HorrorTroll/Artemisia/README.md

# Artemisia
A Pro Micro using ArteryTek AT32F415 MCU
