HorrorTroll/Artemisia/images/castellated_holes/artemisia_back_2.png

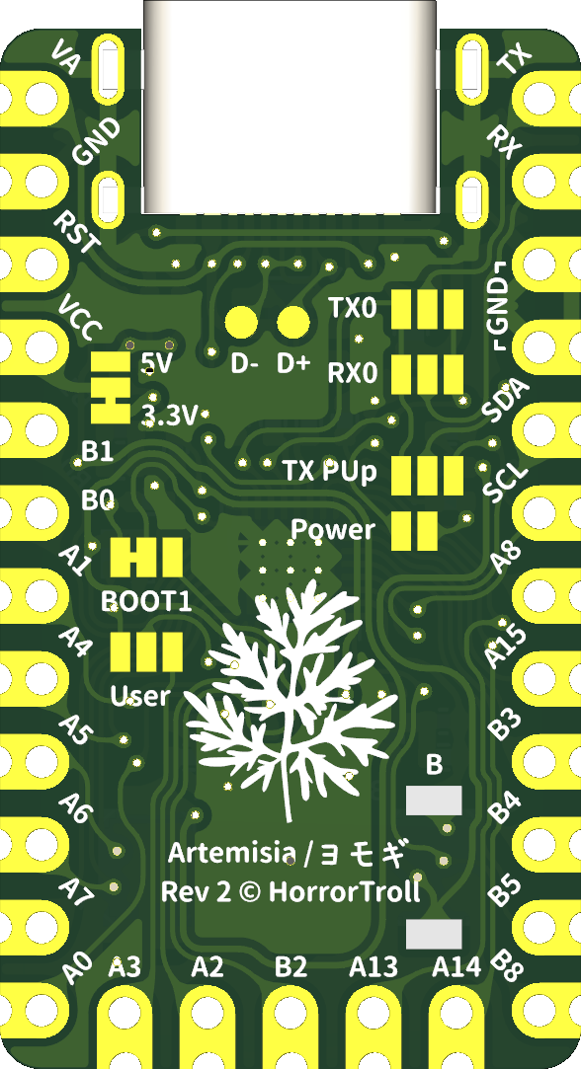
images/castellated_holes/artemisia_back_2.png
