HorrorTroll/Artemisia/images/castellated_holes/artemisia_front.png

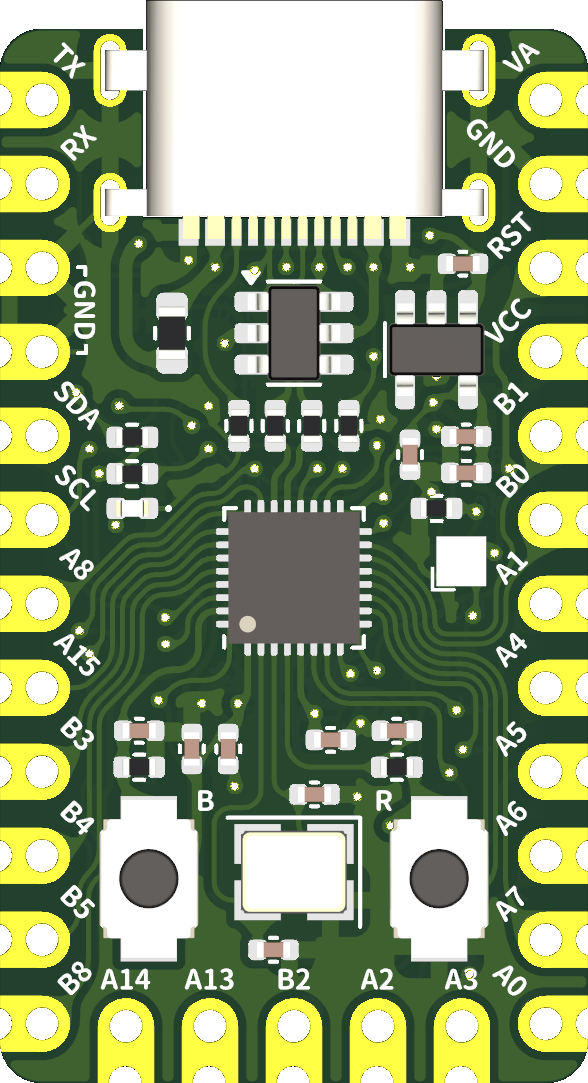
images/castellated_holes/artemisia_front.png
