HorrorTroll/Artemisia/manufacturing/rev2/castellated_holes/drop_in/artemisia.step

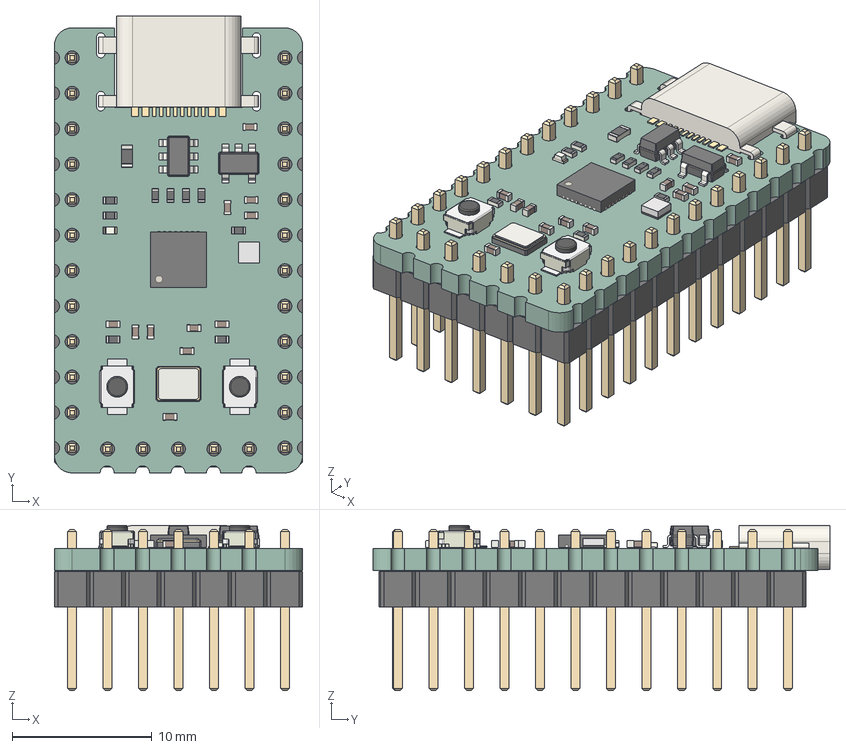
[picture p3: CAD file, 2024-04-25]
manufacturing/rev2/castellated_holes/drop_in/artemisia.step
17.8 x 32.7 x 11.8 mm
C_0402_1005Metric x 11
R_0402_1005Metric x 9
SOT_23_6
USB-C-C168688 v2
PinHeader_1x05_P254mm_Vertical
SW_SPST_B3U-1000P x 2
QFN-32-1EP_4x4mm_Pitch0.4mm
SOT_23_5
Fuse_0603_1608Metric
SK6805-EC15 v5
Crystal_SMD_3225-4Pin_3.2x2.5mm
LED_0402_1005Metric
PinHeader_1x12_P254mm_Vertical x 2
artemisia_PCB
