HorrorTroll/Artemisia/manufacturing/rev2/normal_holes/drop_in/artemisia_gerbers/artemisia-drl_map.dxf

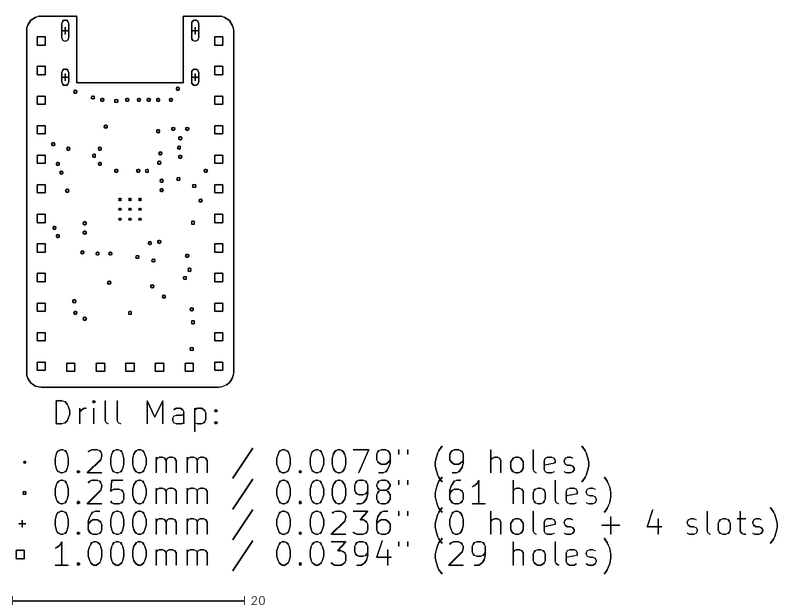
[picture p5: CAD file, 2024-04-25]
manufacturing/rev2/normal_holes/drop_in/artemisia_gerbers/artemisia-drl_map.dxf
65.4 x 47.9
