HorrorTroll/Artemisia/(list of files, cad)

Other CAD files:
manufacturing/rev2/castellated_holes/non_drop_in/artemisia.step
manufacturing/rev2/normal_holes/drop_in/artemisia.step
manufacturing/rev2/normal_holes/non_drop_in/artemisia.step
