HorrorTroll/Artemisia/pcb/rev1/artemisia.pdf

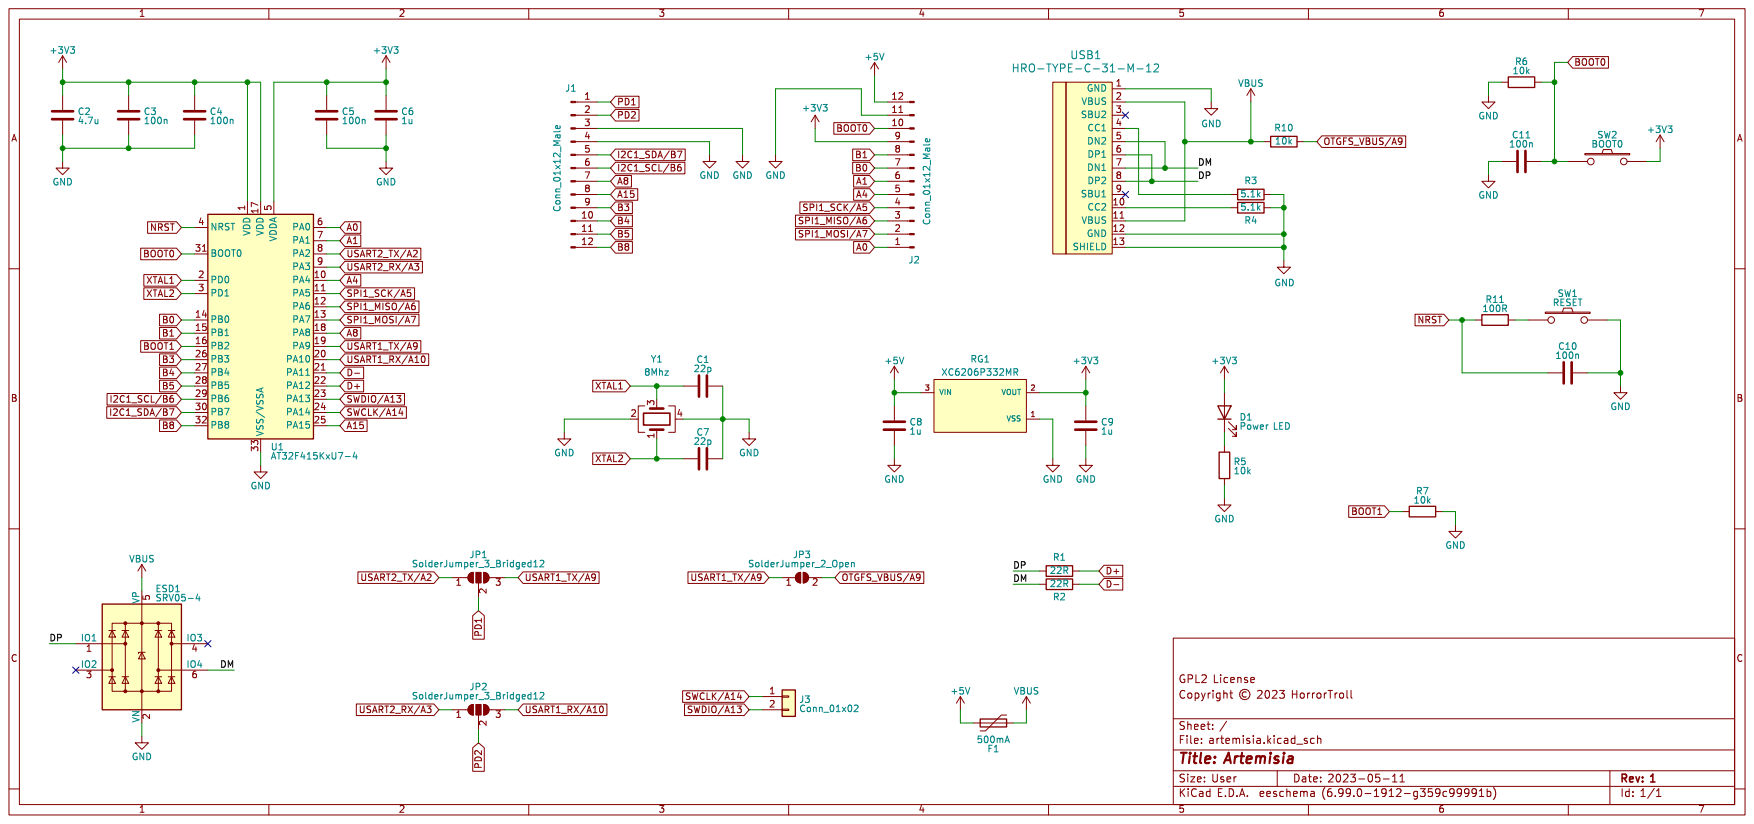
[picture p6: page 1]

1 PA4 10 PA5 11 PA6 12 PA7 13 PB0 14 PB1 15 PB2 16 VDD 17 PA8 18 PA9 19 PD0 2 PA10 20 PA11 21 PA12 22 PA13 23 PA14 24 PA15 25 PB3 26 PB4 27 PB5 28 PB6 29 PD1 3 PB7 30 BOOT0 31 PB8 32 VSS/VSSA 33 NRST 4 VDDA

File: artemisia.kicad_sch Sheet: / þÿCopyright © 2023 HorrorTroll GPL2 LicenseD1Power LED
