HorrorTroll/Artemisia/pcb/rev2/normal_holes/non_drop_in/artemisia.kicad_pcb

## KiCad design pcb/rev2/normal_holes/non_drop_in/artemisia.kicad_pcb (2024-04-25)

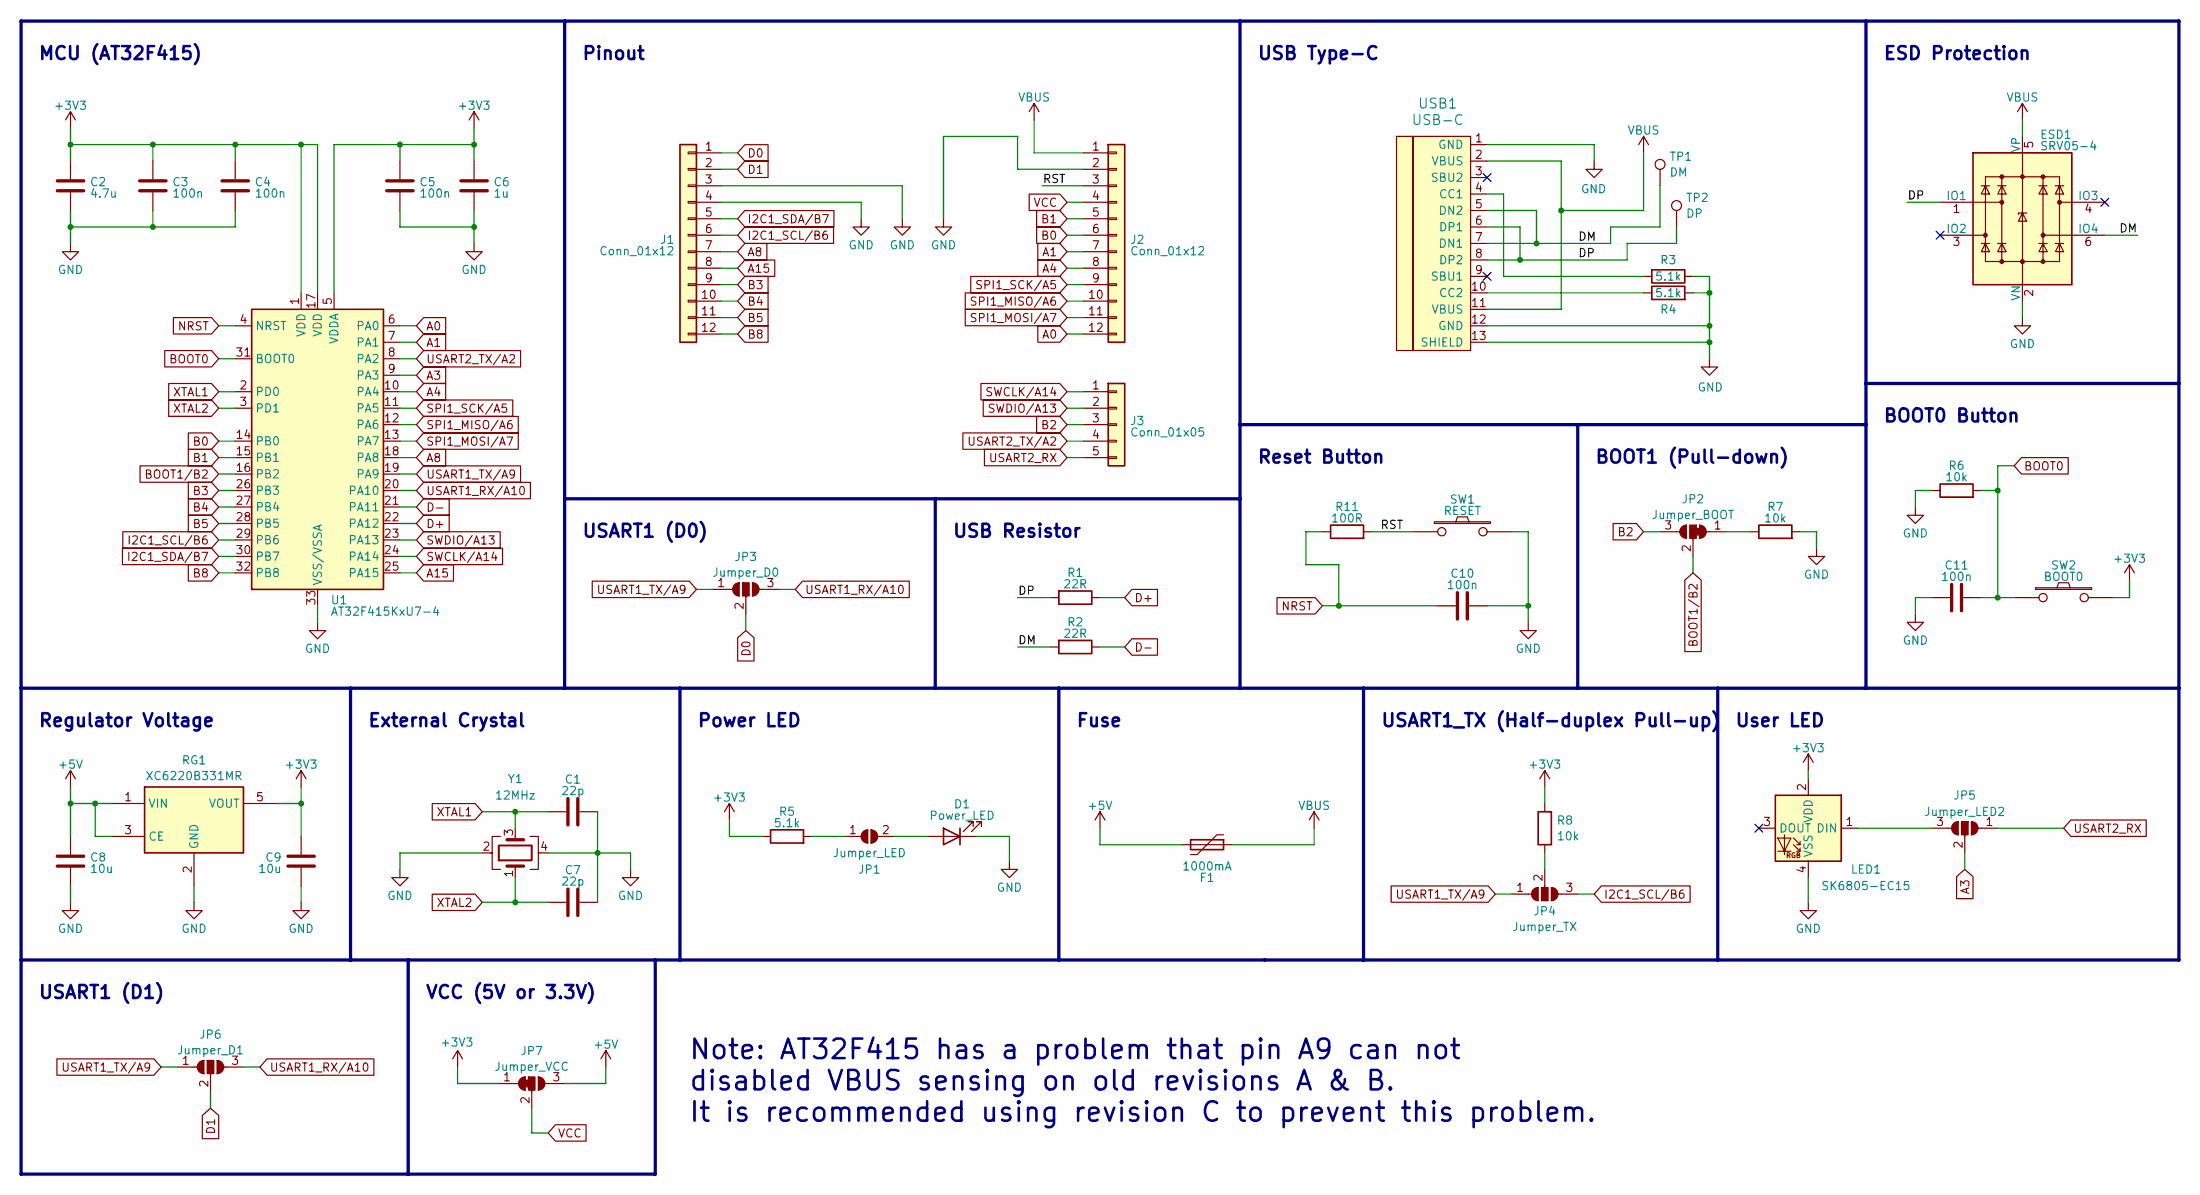
[picture p7: schematic artemisia.kicad_sch]

Parts:
C1, C7: 22p; C_0402_1005Metric; LCSC Part Number C1555
C2: 4.7u; C_0402_1005Metric; LCSC Part Number C23733
C3, C4, C5, C10, C11: 100n; C_0402_1005Metric; LCSC Part Number C1525
C6: 1u; C_0402_1005Metric; LCSC Part Number C52923
C8, C9: 10u; C_0402_1005Metric; LCSC Part Number C15525
D1: Power_LED; LED_0402_1005Metric; LCSC Part Number C965794
ESD1: SRV05-4; SOT-23-6; LCSC Part Number C85364
F1: 1000mA; Fuse_0603_1608Metric; LCSC Part Number C516069
J1: Conn_01x12; Pinouts_Holes_01x12_flip
J2: Conn_01x12; Pinouts_Holes_01x12
J3: Conn_01x05; Pinouts_Holes_01x05
JP1: Jumper_LED; SolderJumper-2_Open_Small
JP2: Jumper_BOOT; SolderJumper-3_Bridged_12_Small
JP3: Jumper_D0; SolderJumper-3_Open_Small
JP4: Jumper_TX; SolderJumper-3_Open_Small
JP5: Jumper_LED2; SolderJumper-3_Open_Small
JP6: Jumper_D1; SolderJumper-3_Open_Small
JP7: Jumper_VCC; SolderJumper-3_Bridged_12_Small
LED1: SK6805-EC15; LED_SK6805_EC15_1.5x1.5mm; LCSC Part Number C2890035
R1, R2: 22R; R_0402_1005Metric; LCSC Part Number C25092
R3, R4, R5: 5.1k; R_0402_1005Metric; LCSC Part Number C25905
R6, R7, R8: 10k; R_0402_1005Metric; LCSC Part Number C25744
R11: 100R; R_0402_1005Metric; LCSC Part Number C25076
RG1: XC6220B331MR; SOT-23-5_custom; LCSC Part Number C3040644
SW1: RESET; SW_SPST_Little_Turtle_2P_no_silk; LCSC Part Number C720477
SW2: BOOT0; SW_SPST_Little_Turtle_2P_no_silk_reversible; LCSC Part Number C720477
TP1: DM; TestPoint_Pad_D1.0mm_no_silk
TP2: DP; TestPoint_Pad_D1.0mm_no_silk
U1: AT32F415KxU7-4; QFN-32_4x4mm_ThermalVias; LCSC Part Number C528424
USB1: USB-C; USB-C-C168688; LCSC Part Number C3019717
Y1: 12MHz; Crystal_SMD_3225-4Pin_3.2x2.5mm; LCSC Part Number C9002

Connections:
+3V3: C2.2, C3.2, C4.2, C5.2, C6.2, C9.1, JP7.1 (A), LED1.2 (VDD), R5.1, R8.2, RG1.5 (VOUT), SW2.2, U1.1 (VDD), U1.5 (VDDA), U1.17 (VDD)
+5V: C8.2, F1.2, JP7.3 (B), RG1.1 (VIN), RG1.3 (CE)
/DM: ESD1.6 (IO4), R2.2, TP1.1, USB1.5 (DN2), USB1.7 (DN1)
/DP: ESD1.1 (IO1), R1.2, TP2.1, USB1.6 (DP1), USB1.8 (DP2)
/RST: J2.3, R11.2, SW1.1
A0: J2.12, U1.6 (PA0)
A1: J2.7, U1.7 (PA1)
A3: JP5.2 (C), U1.9 (PA3)
A4: J2.8, U1.10 (PA4)
A8: J1.7, U1.18 (PA8)
A15: J1.8, U1.25 (PA15)
B0: J2.6, U1.14 (PB0)
B1: J2.5, U1.15 (PB1)
B2: J3.3, JP2.3 (B)
B3: J1.9, U1.26 (PB3)
B4: J1.10, U1.27 (PB4)
B5: J1.11, U1.28 (PB5)
B8: J1.12, U1.32 (PB8)
BOOT0: C11.2, R6.2, SW2.1, U1.31 (BOOT0)
BOOT1/B2: JP2.2 (C), U1.16 (PB2)
D0: J1.1, JP3.2 (C)
D1: J1.2, JP6.2 (C)
D+: R1.1, U1.22 (PA12)
D-: R2.1, U1.21 (PA11)
GND: C1.2, C2.1, C3.1, C4.1, C5.1, C6.1, C7.2, C8.1, C9.2, C10.1, C11.1, D1.1 (K), ESD1.2 (VN), J1.3, J1.4, J2.2, LED1.4 (VSS), R3.1, R4.2, R6.1, R7.2, RG1.2 (GND), SW1.2, U1.33 (VSS/VSSA), USB1.1 (GND), USB1.12 (GND), USB1.13 (SHIELD), Y1.2, Y1.4
I2C1_SCL/B6: J1.6, JP4.3 (B), U1.29 (PB6)
I2C1_SDA/B7: J1.5, U1.30 (PB7)
NRST: C10.2, R11.1, U1.4 (NRST)
unnamed: D1.2 (A), JP1.2 (B)
unnamed: JP1.1 (A), R5.2
unnamed: JP2.1 (A), R7.1
unnamed: JP4.2 (C), R8.1
unnamed: JP5.3 (B), LED1.1 (DIN)
unnamed: R3.2, USB1.4 (CC1)
unnamed: R4.1, USB1.10 (CC2)
SPI1_MISO/A6: J2.10, U1.12 (PA6)
SPI1_MOSI/A7: J2.11, U1.13 (PA7)
SPI1_SCK/A5: J2.9, U1.11 (PA5)
SWCLK/A14: J3.1, U1.24 (PA14)
SWDIO/A13: J3.2, U1.23 (PA13)
USART1_RX/A10: JP3.3 (B), JP6.3 (B), U1.20 (PA10)
USART1_TX/A9: JP3.1 (A), JP4.1 (A), JP6.1 (A), U1.19 (PA9)
USART2_RX: J3.5, JP5.1 (A)
USART2_TX/A2: J3.4, U1.8 (PA2)
VBUS: ESD1.5 (VP), F1.1, J2.1, USB1.2 (VBUS), USB1.11 (VBUS)
VCC: J2.4, JP7.2 (C)
XTAL1: C1.1, U1.2 (PD0), Y1.3
XTAL2: C7.1, U1.3 (PD1), Y1.1

Notes on the sheet:
BOOT0 Button
MCU (AT32F415)
USART1 (D0)
USART1 (D1)
Power LED
ESD Protection
Regulator Voltage
VCC (5V or 3.3V)
Note: AT32F415 has a problem that pin A9 can not disabled VBUS sensing on old revisions A & B. It is recommended using revision C to prevent this problem.
User LED
USB Resistor
BOOT1 (Pull-down)
Pinout
External Crystal
USB Type-C
USART1_TX (Half-duplex Pull-up)
Fuse
Reset Button

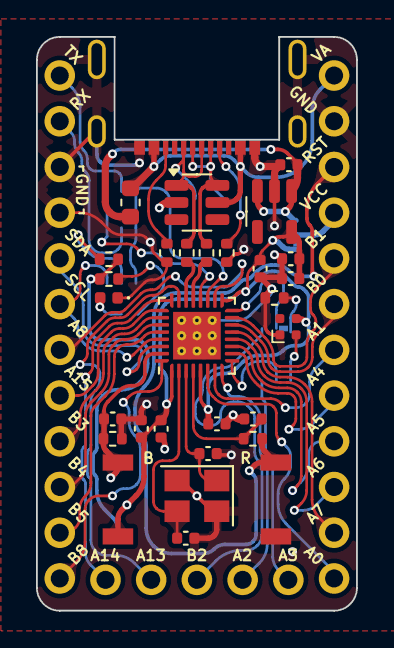
[picture p8: board pcb/rev2/normal_holes/non_drop_in/artemisia.kicad_pcb from above]

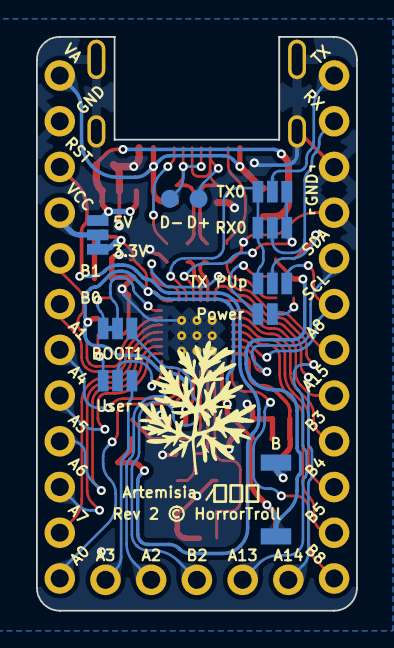
[picture p9: board pcb/rev2/normal_holes/non_drop_in/artemisia.kicad_pcb from below]

Board: 2 copper layers, 17.8 x 31.9 mm, 42 parts (10 on the bottom side), 48 nets.
