HorrorTroll/Artemisia/pcb/rev1/artemisia.kicad_pcb

## KiCad design pcb/rev1/artemisia.kicad_pcb (2024-04-25, an earlier design)

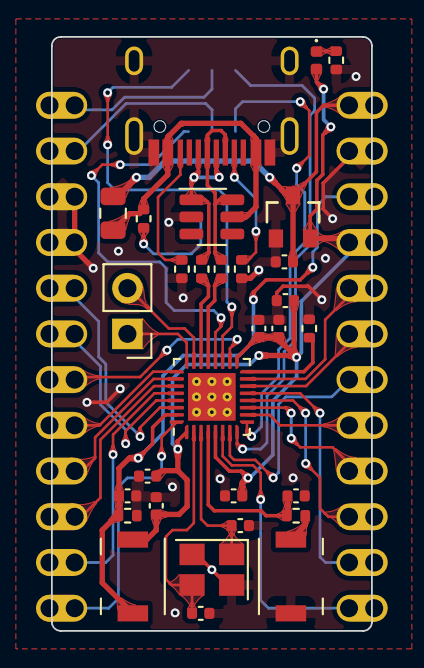
[picture p10: board pcb/rev1/artemisia.kicad_pcb from above]

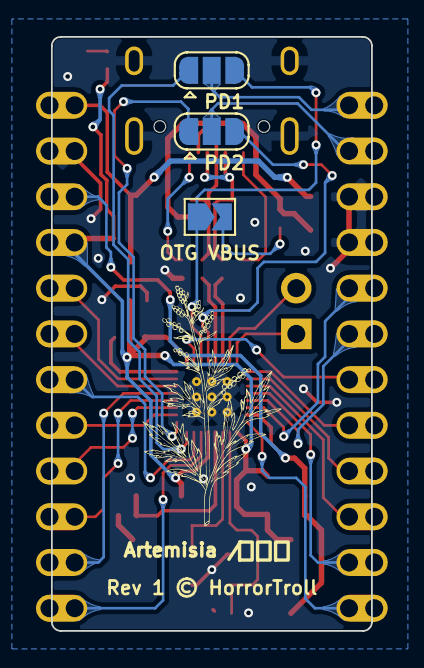
[picture p11: board pcb/rev1/artemisia.kicad_pcb from below]

Board: 2 copper layers, 17.8 x 33.0 mm, 35 parts (3 on the bottom side), 42 nets.

Parts:
C1, C7: 22p; C_0402_1005Metric
C2: 4.7u; C_0402_1005Metric
C3, C4, C5, C10, C11: 100n; C_0402_1005Metric
C6, C8, C9: 1u; C_0402_1005Metric
D1: Power LED; LED_0402_1005Metric
ESD1: SRV05-4; SOT-23-6
F1: 500mA; Fuse_0805_2012Metric
J1, J2: Conn_01x12_Male; Pinouts_Castellated_Oval_01x12
J3: Conn_01x02; PinHeader_1x02_P2.54mm_Vertical
JP1, JP2: SolderJumper_3_Bridged12; SolderJumper-3_P1.3mm_Open_RoundedPad1.0x1.5mm
JP3: SolderJumper_2_Open; SolderJumper-2_P1.3mm_Open_TrianglePad1.0x1.5mm
R1, R2: 22R; R_0402_1005Metric
R3, R4: 5.1k; R_0402_1005Metric
R5, R6, R7, R10: 10k; R_0402_1005Metric
R11: 100R; R_0402_1005Metric
RG1: XC6206P332MR
SW1: RESET; SW_SPST_Litte_Turtle_2P
SW2: BOOT0; SW_SPST_Litte_Turtle_2P
U1: AT32F415KxU7-4; AT32F4xx_QFN-32_4x4mm
USB1: HRO-TYPE-C-31-M-12
Y1: 8Mhz; Crystal_SMD_3225-4Pin_3.2x2.5mm

Connections:
+3V3: C2.2, C3.2, C4.2, C5.2, C6.2, C9.1, D1.2 (A), J2.9, RG1.2 (VOUT), SW2.2, U1.1 (VDD), U1.5 (VDDA), U1.17 (VDD)
+5V: C8.1, F1.2, J2.12, RG1.3 (VIN)
/DM: ESD1.6 (IO4), R2.2, USB1.5 (DN2), USB1.7 (DN1)
/DP: ESD1.1 (IO1), R1.2, USB1.6 (DP1), USB1.8 (DP2)
A0: J2.1, U1.6 (PA0)
A1: J2.6, U1.7 (PA1)
A4: J2.5, U1.10 (PA4)
A8: J1.7, U1.18 (PA8)
A15: J1.8, U1.25 (PA15)
B0: J2.7, U1.14 (PB0)
B1: J2.8, U1.15 (PB1)
B3: J1.9, U1.26 (PB3)
B4: J1.10, U1.27 (PB4)
B5: J1.11, U1.28 (PB5)
B8: J1.12, U1.32 (PB8)
BOOT0: C11.2, J2.10, R6.2, SW2.1, U1.31 (BOOT0)
BOOT1: R7.1, U1.16 (PB2)
D+: R1.1, U1.22 (PA12)
D-: R2.1, U1.21 (PA11)
GND: C1.2, C2.1, C3.1, C4.1, C5.1, C6.1, C7.2, C8.2, C9.2, C10.1, C11.1, ESD1.2 (VN), J1.3, J1.4, J2.11, R3.1, R4.2, R5.1, R6.1, R7.2, RG1.1 (VSS), SW1.2, U1.33 (VSS/VSSA), USB1.1 (GND), USB1.12 (GND), USB1.13 (SHIELD), Y1.2, Y1.4
I2C1_SCL/B6: J1.6, U1.29 (PB6)
I2C1_SDA/B7: J1.5, U1.30 (PB7)
NRST: C10.2, R11.1, U1.4 (NRST)
unnamed: D1.1 (K), R5.2
unnamed: R11.2, SW1.1
unnamed: R3.2, USB1.4 (CC1)
unnamed: R4.1, USB1.10 (CC2)
OTGFS_VBUS/A9: JP3.2 (B), R10.1
PD1: J1.1, JP1.2 (C)
PD2: J1.2, JP2.2 (C)
SPI1_MISO/A6: J2.3, U1.12 (PA6)
SPI1_MOSI/A7: J2.2, U1.13 (PA7)
SPI1_SCK/A5: J2.4, U1.11 (PA5)
SWCLK/A14: J3.1, U1.24 (PA14)
SWDIO/A13: J3.2, U1.23 (PA13)
USART1_RX/A10: JP2.3 (B), U1.20 (PA10)
USART1_TX/A9: JP1.3 (B), JP3.1 (A), U1.19 (PA9)
USART2_RX/A3: JP2.1 (A), U1.9 (PA3)
USART2_TX/A2: JP1.1 (A), U1.8 (PA2)
VBUS: ESD1.5 (VP), F1.1, R10.2, USB1.2 (VBUS), USB1.11 (VBUS)
XTAL1: C1.1, U1.2 (PD0), Y1.3
XTAL2: C7.1, U1.3 (PD1), Y1.1
