HorrorTroll/Artemisia/(notices)

Notices in the files:
pcb/rev2/castellated_holes/drop_in/artemisia.kicad_pcb:
Copyright © 2024 HorrorTroll
Rev 2 © HorrorTroll
pcb/rev1/artemisia.kicad_pcb:
Rev 1 © HorrorTroll
